FabLabCasaCorsini/bracciorobotmatera/docs/images/RBDLiveStart.jpg

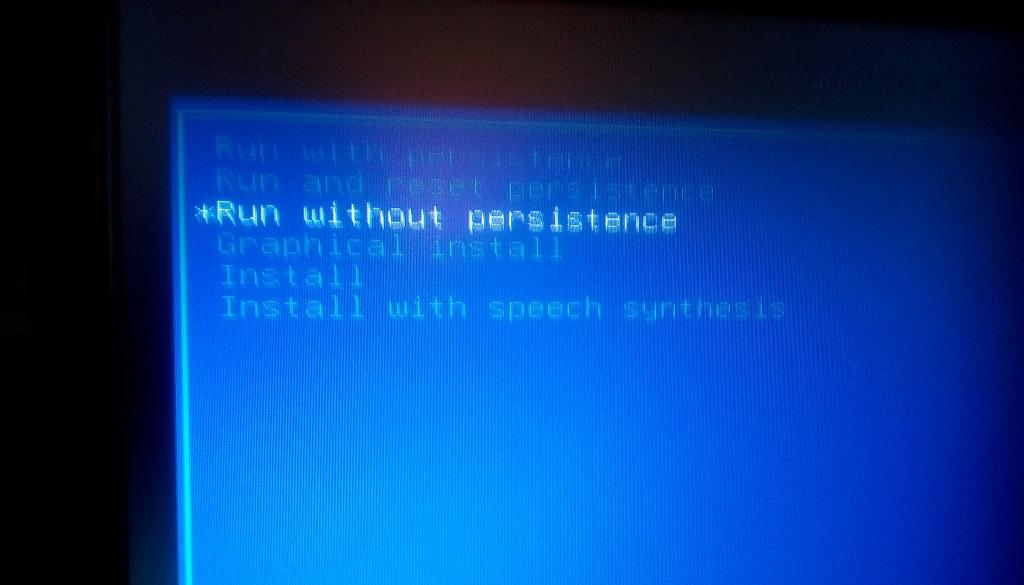
docs/images/RBDLiveStart.jpg
