FabLabCasaCorsini/bracciorobotmatera/docs/images/DebianVM04.png

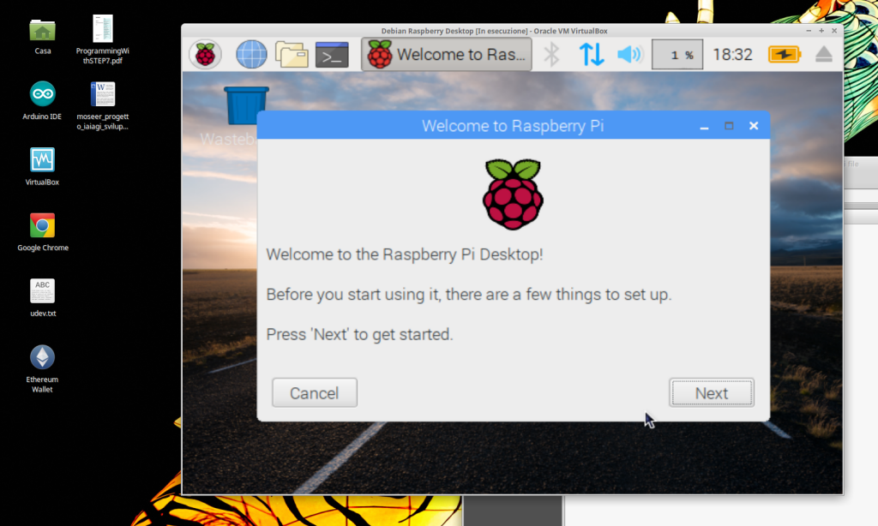
docs/images/DebianVM04.png
