FabLabCasaCorsini/bracciorobotmatera/README.md

# BraccioRobotMatera

## Progetto bracccio robotico per Matera 2019

Progetto collaborativo per la realizzazione di un braccio robotico in grado di riprodurre disegni su di una superficie fosforescente, da utilizzare in una casa-grotta di Matera.

## Partecipanti:
* Caterina Bonora
* Alice Toni
* Doriano Dalpiaz
* Francesco Finotti
* Lorenzo Vandelli
* Luca Bazzucchi
* Alberto Trentadue
* Alessandro Appeddu
* Michele Tracquilio
* Andrea Forlani
* Augusto Maffei
* Francesco Annovi
* Nadir Abdelmjid

## Descrizione del progetto

http://www.casacorsini.mo.it/wp-content/uploads/2018/09/INTERABITAZIONE-condiviso-low.pdf
