FabLabCasaCorsini/bracciorobotmatera/docs/README.md

# Directory docs
Sezione del repository da utilizzare per la documentazione
