FabLabCasaCorsini/bracciorobotmatera/docs/images/Arch.png

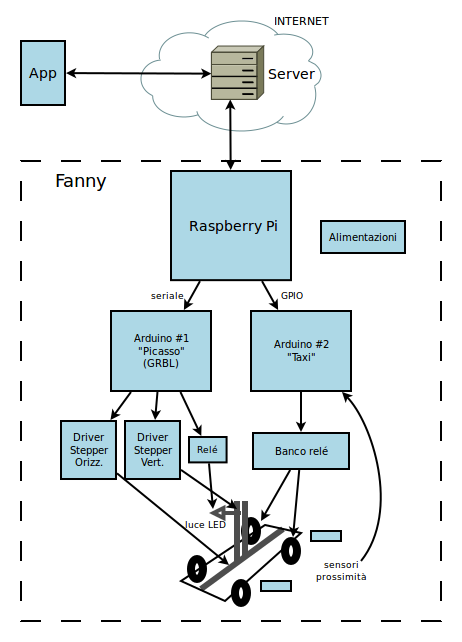
docs/images/Arch.png
