FabLabCasaCorsini/bracciorobotmatera/docs/images/DebianVM01.png

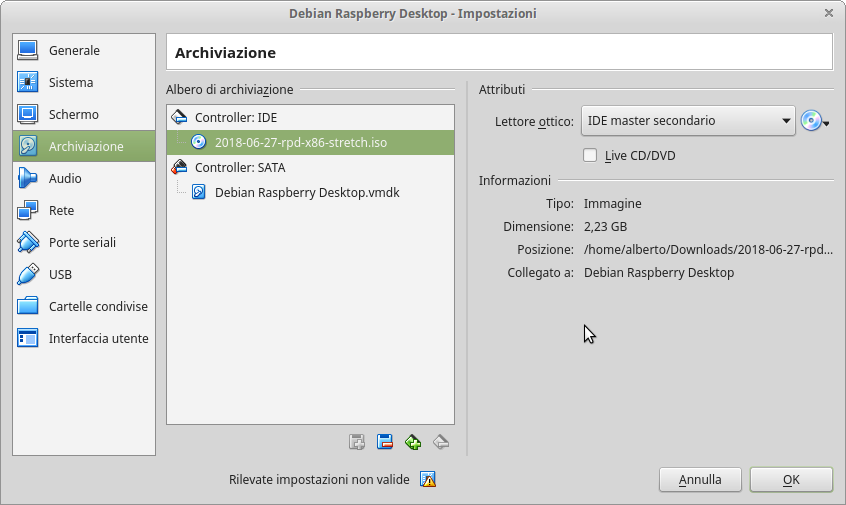
docs/images/DebianVM01.png
