FabLabCasaCorsini/bracciorobotmatera/docs/images/DebianVM02.png

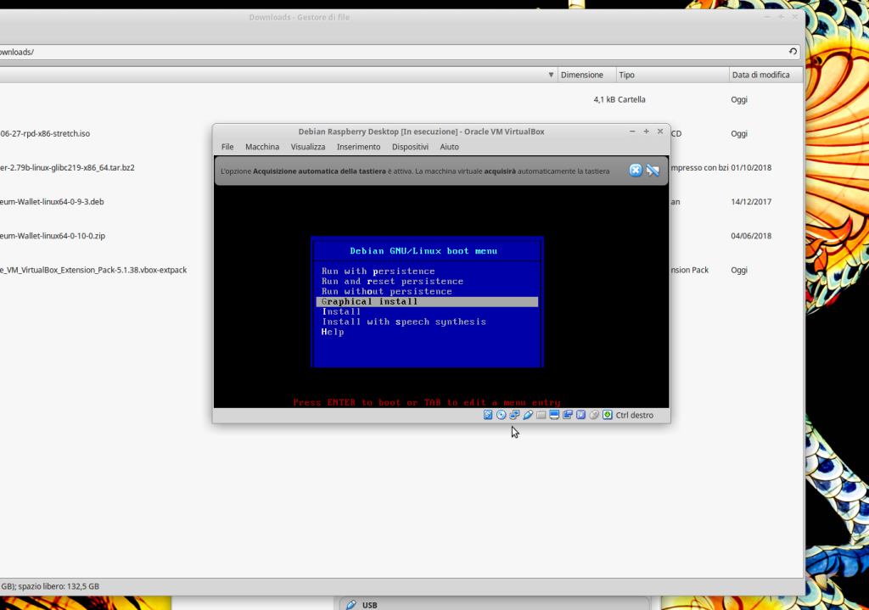
docs/images/DebianVM02.png
