FabLabCasaCorsini/bracciorobotmatera/docs/images/DebianVM03.png

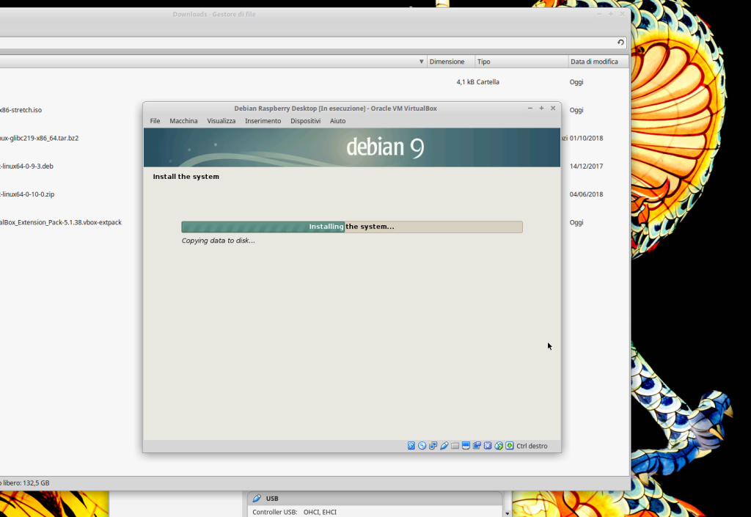
docs/images/DebianVM03.png
