FabLabCasaCorsini/bracciorobotmatera/docs/images/RBDDesktop.jpg

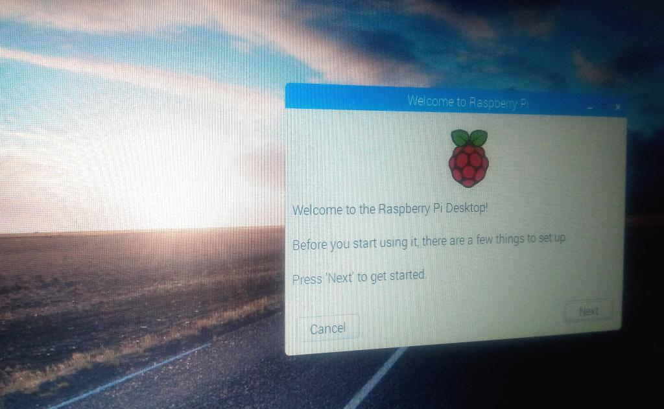
docs/images/RBDDesktop.jpg
