FabLabCasaCorsini/bracciorobotmatera/docs/images/RBDStarupScreen.jpg

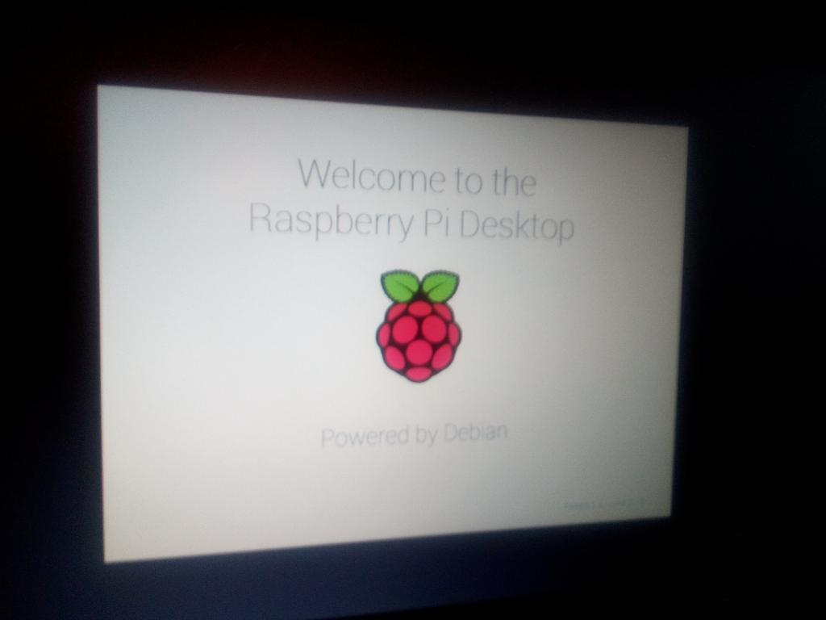
docs/images/RBDStarupScreen.jpg
