FabLabCasaCorsini/bracciorobotmatera/docs/images/ReleFanny.png

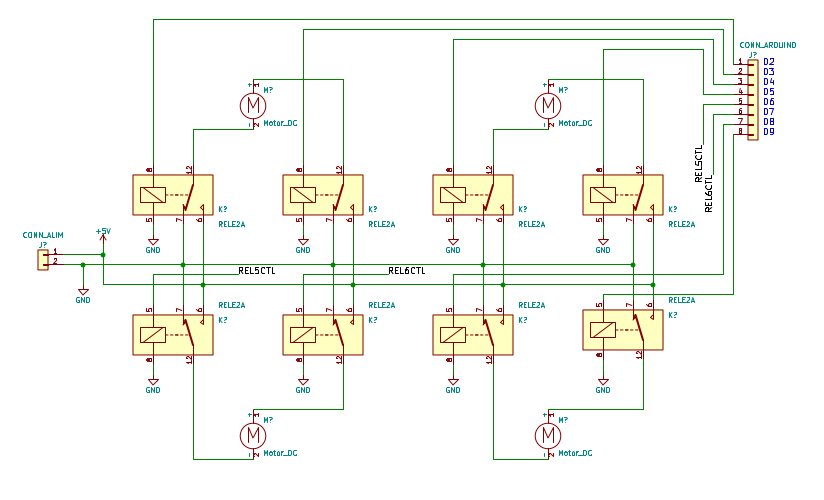
docs/images/ReleFanny.png
