FabLabCasaCorsini/bracciorobotmatera/docs/images/RPi-SW-Arch02.png

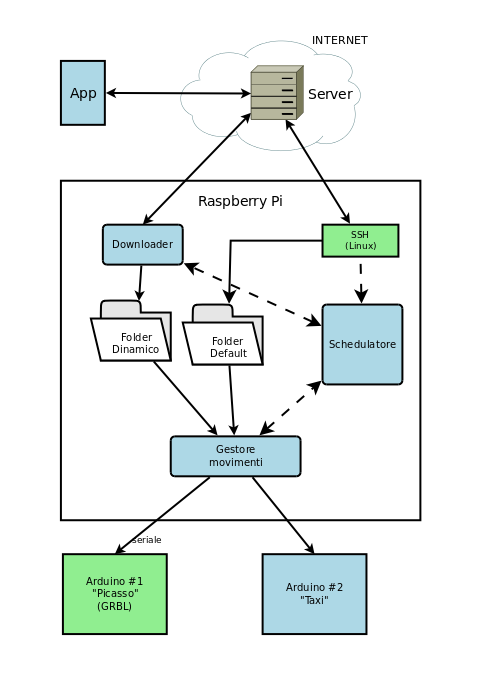
docs/images/RPi-SW-Arch02.png
