FabLabCasaCorsini/bracciorobotmatera/docs/images/schema_grbl.png

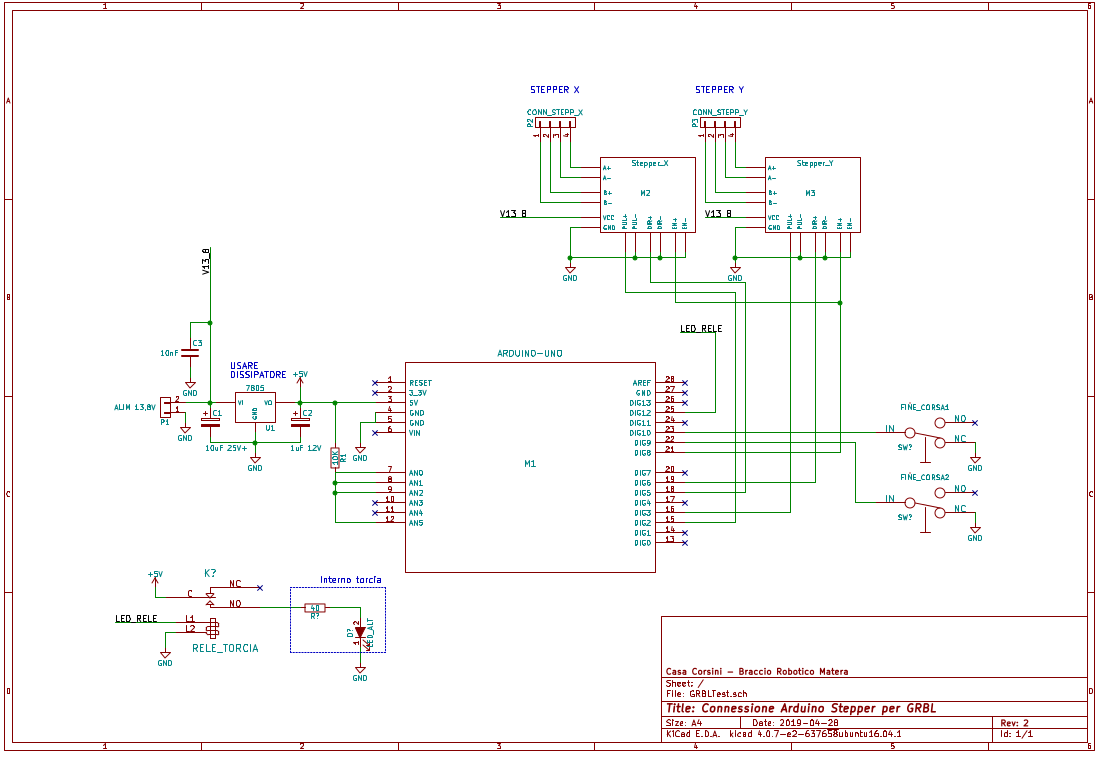
docs/images/schema_grbl.png
