FabLabCasaCorsini/bracciorobotmatera/docs/images/SWPlan_2019-04-28.png

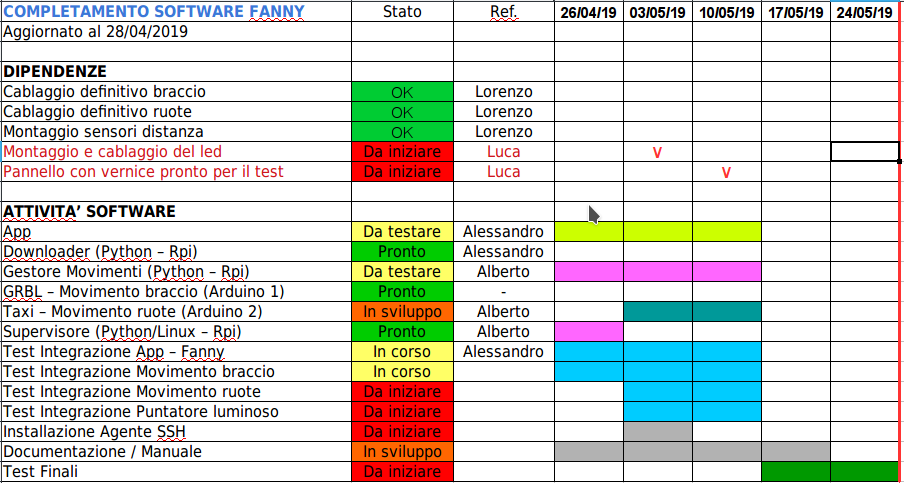
docs/images/SWPlan_2019-04-28.png
