FabLabCasaCorsini/bracciorobotmatera/(threads)

Thread 4 (2019-04-17):

Test dei fine-corsa e posizionamento braccio sullo 0

albtrentadue, 2019-04-17:

albtrentadue, 2019-04-17:
https://github.com/gnea/grbl/wiki/Set-up-the-Homing-Cycle

albtrentadue, 2019-04-28:
Fine corsa funzionano con GRBL
Il posizionamento sullo 0 dipende dalla Issue #8

albtrentadue, 2019-04-29:
Completato.
Settaggi: $3=3  $23=3

Closed 2019-04-29.

Thread 6 (2019-04-17):

Alimentazione 5V della Raspberry

albtrentadue, 2019-04-17:

albtrentadue, 2019-04-17:
http://www.raspberry-pi-geek.com/howto/GPIO-Pinout-Rasp-Pi-1-Rev1-and-Rev2
Pin P1-02 +5
Pin P1-06 GND

albtrentadue, 2019-05-09:
Cambiato approccio: Alimentata da ingresso USB Micro da un'alimentatore cilindrico da auto per cellulari.
Attività in corso.

Closed 2019-05-14.

Thread 7 (2019-04-17):

Controllo della penna LED con GRBL

albtrentadue, 2019-04-17:
Implementazione nel movemaker.
Dipende dal cablaggio Issue #5

albtrentadue, 2019-05-05:
Comandi GRBL:
M3 S255 -> accende
M5 -> spegne

Closed 2019-05-05.

Thread 9 (2019-05-05):

Tuning velocità movimento braccio

albtrentadue, 2019-05-05:
Determinare i parametri GRBL per il movimento braccio in base alla velocità di impressione della vernice sul pannello

albtrentadue, 2019-05-05:
Dipende da Issue #10

Closed 2019-05-16.

Thread 27 (2019-05-23):

Il carrello percorre distanze diverse nelle due direzioni

albtrentadue, 2019-05-23:
Potrebbe essere un limite della soluzione che fa uso di motori in continua ridotti, uno per ciascuna ruota

albtrentadue, 2020-02-14:
Non più rilevante dopo la modifica della trazione a controllo PWM
Chiudere

Closed 2020-02-14.

Thread 29 (2019-11-06):

Sensori di prossimità per il movimento del carrello

albtrentadue, 2019-11-06:
Introdurre la gestione di sensori di prossimità per assicurare lo stop del carrello a fine corsa. medante l'introduzione di pannelli di fine corsa.
Per la risoluzione della issue #27

albtrentadue, 2020-02-14:
I sensori sono stati montati sul carrello.
L'integrazione software verrà effettuata dopo l'evento del 23/02

Thread 30 (2019-11-06):

L'arduino con GRBL perde le configurazioni

albtrentadue, 2019-11-06:
Un effetto visibile è che non funzionano più i fine corsa del braccio.
La soluzione è introdurre le configurazioni hardcoded nel codice di GRBL e poi compilare.

Thread 37 (2020-02-13):

Inversione Lente Torcia

CoffeePerry, 2020-02-13:
### Inversione Lente Torcia
Si propone una modifica migliorativa della torcia montata sul braccio del robot, descritta di seguito.
Attraverso l'inversione della lente della torcia, la quale ora disperde la luce generata dalla sorgente luminosa:

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

si otterrebbe invece una focalizzazione migliore della luce sul pannello:

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

In questo modo si ottiene un tratto più fine, preciso e marcato sul pannello, oltre a permettere alla torcia di essere fissata più saldamente all'asse (quindi più indietro rispetto ad ora), riducendo così le vibrazioni della stessa durante il disegno sul pannello, aumentando dunque l'accuratezza del disegno.

Thread 38 (2020-02-13):

Modifica files GCode

CoffeePerry, 2020-02-13:
### Modifica files GCode

A seguito del recente cambio della sorgente luminosa della torcia, è necessario riadattare la generazione dei files GCode ed i files GCode esistenti sul raspberry (offline), per quanto riguarda il comando di Grbl:

`S900`

il quale deve essere sostituito con:

`S1000`

In quanto la nuova sorgente luminosa necessita di un _duty cycle_ del 100% per emettere luce.

albtrentadue, 2020-02-14:
Questa è una modifica da apportare all'algoritmo di conversione implementato dall'App Android

CoffeePerry, 2020-02-15:
Ho controllato nel codice dell'App Android, ed ho notato che invia al server stringhe del tipo:

`0.0-96.682465-0.0-96.445496-0.9569378-92.891-5.5023923-79.85782-13.875598-60.900475-21.291866-43.127964-29.425838-26.06635-36.1244-15.639811-37.79904-13.744076$$55.023922-100.0-55.50239-98.34123-60.765553-85.54502-71.29186-60.900475-83.97129-33.886257-93.30143-12.559241-100.0-0.0`

Ovvero stringhe di sole coordinate dei punti da disegnare (e _$$_ come separatore di linee), pertanto sospetto che la modifica da attuare sia nel file _php/save.php_ sul server oppure in uno dei file _*.py_ sul Raspberry. Ora li controllo.

CoffeePerry, 2020-02-15:
A mio parere, pure il file _php/save.php_ non necessita di modifiche, in quanto, quando il server riceve una richiesta POST dall'App Android su _save.php_, quest'ultimo produce due file (senza _.txt_ alla fine del nome dei file):

**coord**:
[test-_-7a37bcce-5d79-468a-9f30-ba51a48f1433.coord.txt](https://github.com/FabLabCasaCorsini/bracciorobotmatera/files/4208946/test-_-7a37bcce-5d79-468a-9f30-ba51a48f1433.coord.txt)

**gcode**:
[test-_-7a37bcce-5d79-468a-9f30-ba51a48f1433.gcode.txt](https://github.com/FabLabCasaCorsini/bracciorobotmatera/files/4208947/test-_-7a37bcce-5d79-468a-9f30-ba51a48f1433.gcode.txt)

Il file _coord_ contiene la stringa inviata dall'App Android, mentre nel file _gcode_, vedo che non vengono scritti comandi `S` (Spindle Speed).

Procedo quindi a controllare che l'aggiunta dei vari comandi `S` non sia opera di un qualche script Python sul Raspberry.

CoffeePerry, 2020-02-20:
Risolto da @aappeddu il 19/02/2020 sera, il codice su quale stavamo lavorando non era aggiornato.

Closed 2020-02-20.

Thread 39 (2020-02-14):

Errore nello schema elettrico

albtrentadue, 2020-02-14:
Lo schema elettrico del controllo CNC (braccio) indica erroneamente il pin D12 come linea di controllo della torcia (spindle).
In realtà è il D11
