FabLabCasaCorsini/bracciorobotmatera/(commit log)

2019-02-18 Testato con il server
2019-04-06 Creato lo script di build per RPi
2019-04-06 Build.sh crea il file di versione
2020-05-08 Modifiche per nuovo controllo PWM
